brokenpotatoes/Servo/encoder/encoder.kicad_pcb

## KiCad design encoder/encoder.kicad_pcb (2026-03-05)

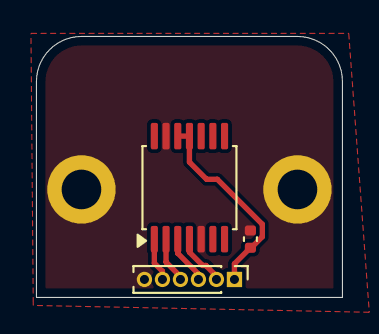
[picture p1: board encoder.kicad_pcb from above]

Board: 2 copper layers, 17.0 x 14.5 mm, 5 parts (0 on the bottom side), 6 nets.

Parts:
C1: 100nF; C_0402_1005Metric
H1, H2: MountingHole_Pad_MP; MountingHole_2.2mm_M2_DIN965_Pad
J1: Conn_01x06_Pin; PinHeader_1x06_P1.00mm_Vertical
U1: AS5047P; TSSOP-14_4.4x5mm_P0.65mm

Connections:
/ENC_CS: J1.5, U1.1 (~CS)
/MISO: J1.3, U1.3 (MISO)
/MOSI: J1.2, U1.4 (MOSI)
/SCK: J1.4, U1.2 (CLK)
GND: C1.2, H1.1, H2.1, J1.6, U1.5 (TST), U1.13 (GND)
VDD: C1.1, J1.1, U1.11 (VDD), U1.12 (VDD3V3)
