brokenpotatoes/Servo/terminator/terminator.kicad_pcb

## KiCad design terminator/terminator.kicad_pcb (2026-03-01)

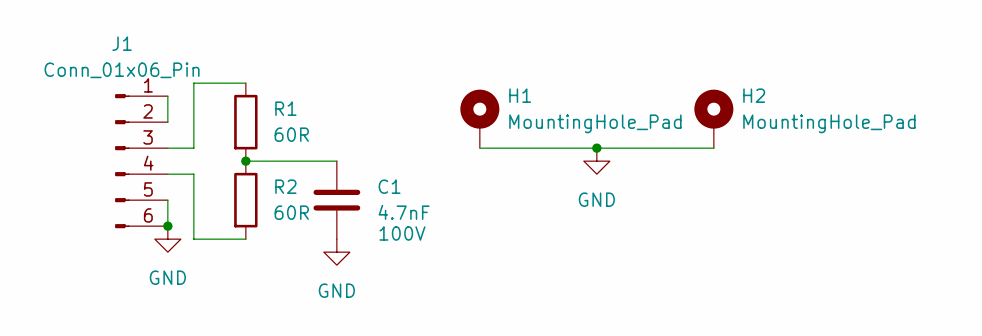
[picture p2: schematic terminator.kicad_sch]

Parts:
C1: 4.7nF; C_1206_3216Metric; Voltage Rating 100V; LCSC Part C393168
H1, H2: MountingHole_Pad; MountingHole_2.2mm_M2_Pad
J1: Conn_01x06_Pin; JST_XH_S6B-XH-A_1x06_P2.50mm_Horizontal; LCSC Part C157919
R1, R2: 60R; C_1206_3216Metric; LCSC Part C2086866

Connections:
GND: C1.2, H1.1, H2.1, J1.5, J1.6
unnamed: C1.1, R1.2, R2.1
unnamed: J1.1, J1.2
unnamed: J1.3, R1.1
unnamed: J1.4, R2.2

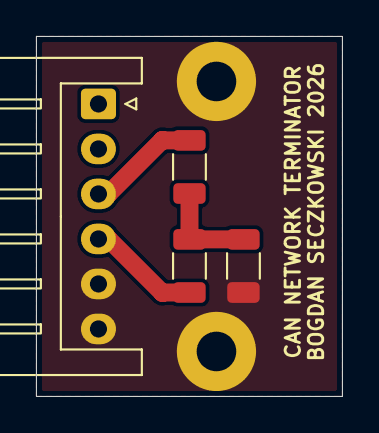
[picture p3: board terminator.kicad_pcb from above]

Board: 2 copper layers, 17.0 x 20.0 mm, 6 parts (0 on the bottom side), 5 nets.
