brokenpotatoes/Servo/servo/servo.kicad_pcb

## KiCad design servo/servo.kicad_pcb (2026-03-01)

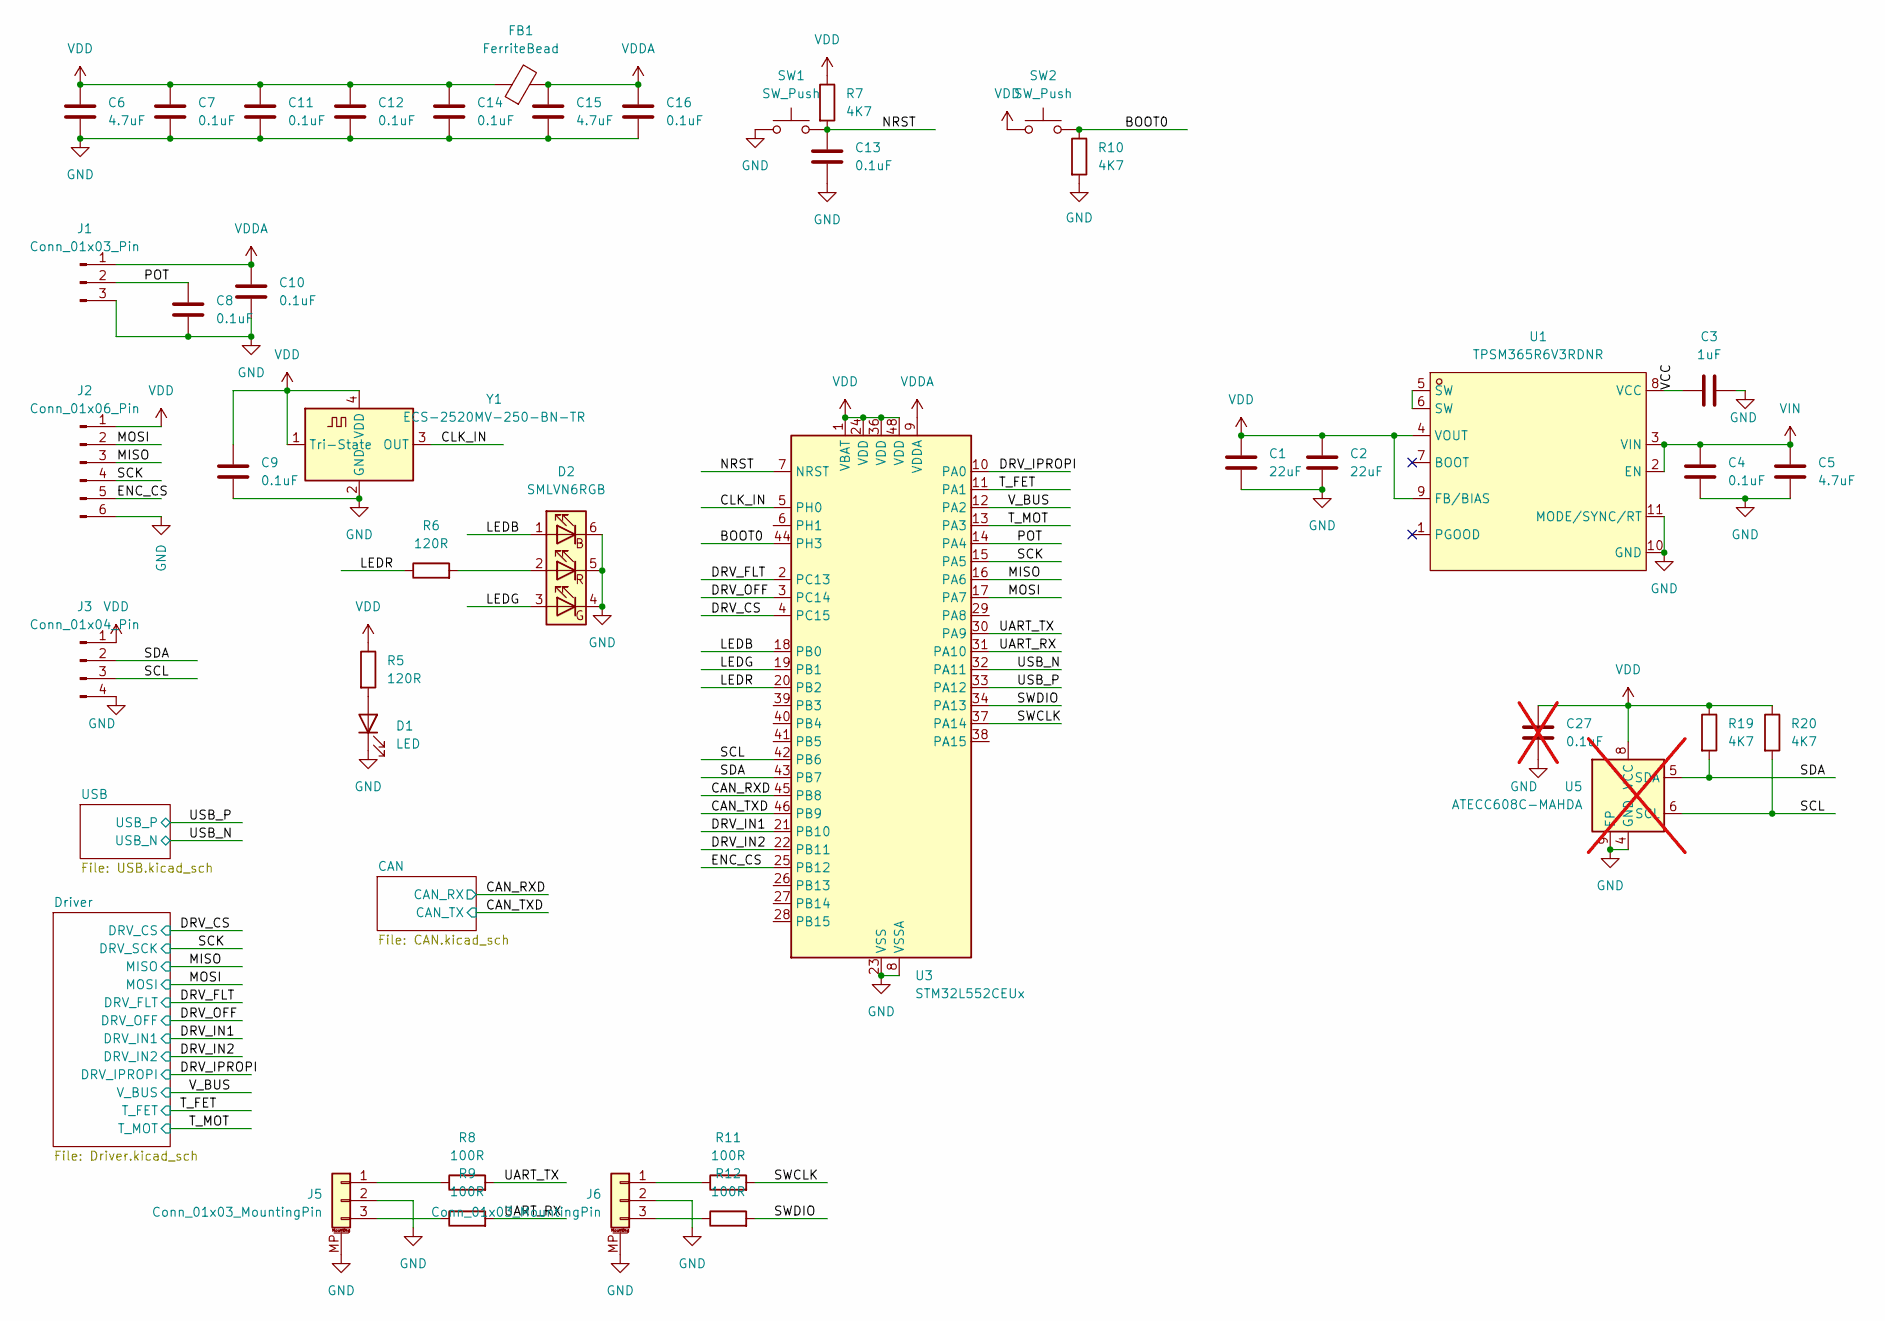
[picture p4: schematic servo.kicad_sch]

Parts:
C1, C2: 22uF; C_0402_1005Metric; Voltage Rating 10V; LCSC Part C3845593
C3: 1uF; C_0402_1005Metric; Voltage Rating 16V; LCSC Part C77006
C4: 0.1uF; C_0603_1608Metric; Voltage Rating 100V; LCSC Part C77058
C5: 4.7uF; C_1206_3216Metric; Voltage Rating 100V; LCSC Part C237304
C6, C15: 4.7uF; C_0402_1005Metric; Voltage Rating 16V; LCSC Part C318563
C7, C8, C9, C10, C11, C12, C13, C14, C16: 0.1uF; C_0402_1005Metric; Voltage Rating 16V; LCSC Part C71629
C27: 0.1uF; C_0402_1005Metric; Voltage Rating 16V; LCSC Part C71629; not fitted
D1: LED; LED_0402_1005Metric; LCSC Part C264407
D2: SMLVN6RGB; LED_ROHM_SMLVN6; LCSC Part C2909770
FB1: FerriteBead; L_0402_1005Metric; LCSC Part C88970
J1: Conn_01x03_Pin; PinHeader_1x03_P1.00mm_Vertical
J2: Conn_01x06_Pin; PinHeader_1x06_P1.00mm_Vertical
J3: Conn_01x04_Pin; PinHeader_1x04_P1.00mm_Vertical
J5, J6: Conn_01x03_MountingPin; JST_GH_SM03B-GHS-TB_1x03-1MP_P1.25mm_Horizontal; LCSC Part C514175
R5, R6: 120R; R_0402_1005Metric; LCSC Part C445577
R7, R10, R19, R20: 4K7; R_0402_1005Metric; LCSC Part C400631
R8, R9, R11, R12: 100R; R_0402_1005Metric; LCSC Part C844502
SW1, SW2: SW_Push; SW_SPST_PTS810; LCSC Part C221895
U1: TPSM365R6V3RDNR; QFN-11_L4.5-W3.5-P0.50-TL_TPSM365R6FRDNR; LCSC Part C18208843
U3: STM32L552CEUx; QFN-48-1EP_7x7mm_P0.5mm_EP5.6x5.6mm; LCSC Part C1236634
U5: ATECC608C-MAHDA; DFN-8-1EP_3x2mm_P0.5mm_EP1.3x1.5mm; LCSC Part C23291019; not fitted
Y1: ECS-2520MV-250-BN-TR; Oscillator_SMD_ECS_2520MV-xxx-xx-4Pin_2.5x2.0mm; LCSC Part C405463

Connections:
/BOOT0: R10.1, SW2.2, U3.44 (PH3)
/CAN_RXD: U3.45 (PB8); also elsewhere on the board
/CAN_TXD: U3.46 (PB9); also elsewhere on the board
/CLK_IN: U3.5 (PH0), Y1.3 (OUT)
/DRV_CS: U3.4 (PC15); also elsewhere on the board
/DRV_FLT: U3.2 (PC13); also elsewhere on the board
/DRV_IN1: U3.21 (PB10); also elsewhere on the board
/DRV_IN2: U3.22 (PB11); also elsewhere on the board
/DRV_IPROPI: U3.10 (PA0); also elsewhere on the board
/DRV_OFF: U3.3 (PC14); also elsewhere on the board
/ENC_CS: J2.5, U3.25 (PB12)
/LEDB: D2.1 (BA), U3.18 (PB0)
/LEDG: D2.3 (GA), U3.19 (PB1)
/LEDR: R6.1, U3.20 (PB2)
/MISO: J2.3, U3.16 (PA6); also elsewhere on the board
/MOSI: J2.2, U3.17 (PA7); also elsewhere on the board
/NRST: C13.1, R7.2, SW1.2, U3.7 (NRST)
/POT: C8.1, J1.2, U3.14 (PA4)
/SCK: J2.4, U3.15 (PA5); also elsewhere on the board
/SCL: J3.3, R20.2, U3.42 (PB6), U5.6 (SCL)
/SDA: J3.2, R19.2, U3.43 (PB7), U5.5 (SDA)
/SWCLK: R11.2, U3.37 (PA14)
/SWDIO: R12.2, U3.34 (PA13)
/T_FET: U3.11 (PA1); also elsewhere on the board
/T_MOT: U3.13 (PA3); also elsewhere on the board
/UART_RX: R9.2, U3.31 (PA10)
/UART_TX: R8.2, U3.30 (PA9)
/USB_N: U3.32 (PA11); also elsewhere on the board
/USB_P: U3.33 (PA12); also elsewhere on the board
/VCC: C3.1, U1.8 (VCC)
/V_BUS: U3.12 (PA2); also elsewhere on the board
GND: C1.2, C2.2, C3.2, C4.2, C5.2, C6.2, C7.2, C8.2, C9.2, C10.2, C11.2, C12.2, C13.2, C14.2, C15.2, C16.2, C27.2, D1.1 (K), D2.4 (GK), D2.5 (RK), D2.6 (BK), J1.3, J2.6, J3.4, J5.2, J5.MP (MountPin), J6.2, J6.MP (MountPin), R10.2, SW1.1, U1.10 (GND), U1.11 (MODE/SYNC/RT), U3.8 (VSSA), U3.23 (VSS), U3.35 (VSS), U3.47 (VSS), U3.49 (VSS), U5.4 (GND), U5.9 (EP), Y1.2 (GND); also elsewhere on the board
unnamed: D1.2 (A), R5.2
unnamed: D2.2 (RA), R6.2
unnamed: J5.1, R8.1
unnamed: J5.3, R9.1
unnamed: J6.1, R11.1
unnamed: J6.3, R12.1
unnamed: U1.5 (SW), U1.6 (SW)
VDD: C1.1, C2.1, C6.1, C7.1, C9.1, C11.1, C12.1, C14.1, C27.1, FB1.1, J2.1, J3.1, R5.1, R7.1, R19.1, R20.1, SW2.1, U1.4 (VOUT), U1.9 (FB/BIAS), U3.1 (VBAT), U3.24 (VDD), U3.36 (VDD), U3.48 (VDD), U5.8 (VCC), Y1.1 (Tri-State), Y1.4 (VDD); also elsewhere on the board
VDDA: C10.1, C15.1, C16.1, FB1.2, J1.1, U3.9 (VDDA); also elsewhere on the board
VIN: C4.1, C5.1, U1.2 (EN), U1.3 (VIN); also elsewhere on the board

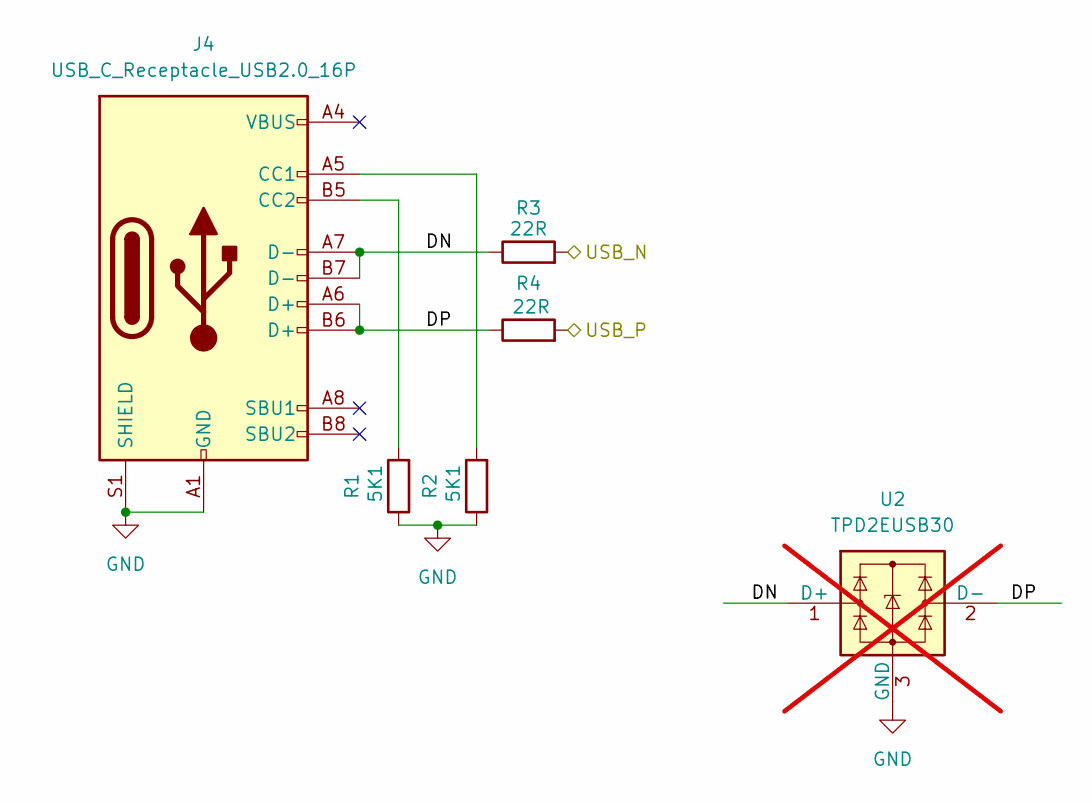
[picture p5: schematic USB.kicad_sch]

Parts:
J4: USB_C_Receptacle_USB2.0_16P; USB_C_Receptacle_GCT_USB4105-xx-A_16P_TopMnt_Horizontal; LCSC Part C3020560
R1, R2: 5K1; R_0402_1005Metric; LCSC Part C278598
R3, R4: 22R; R_0402_1005Metric; LCSC Part C482106
U2: TPD2EUSB30; Texas_DRT-3; LCSC Part C94934; not fitted

Connections:
/USB/DN: J4.A7 (D-), J4.B7 (D-), R3.1, U2.1 (D+)
/USB/DP: J4.A6 (D+), J4.B6 (D+), R4.1, U2.2 (D-)
/USB_N: R3.2; also elsewhere on the board
/USB_P: R4.2; also elsewhere on the board
GND: J4.A1 (GND), J4.A12 (GND), J4.B1 (GND), J4.B12 (GND), J4.S1 (SHIELD), R1.1, R2.1, U2.3 (GND); also elsewhere on the board
unnamed: J4.A5 (CC1), R2.2
unnamed: J4.B5 (CC2), R1.2

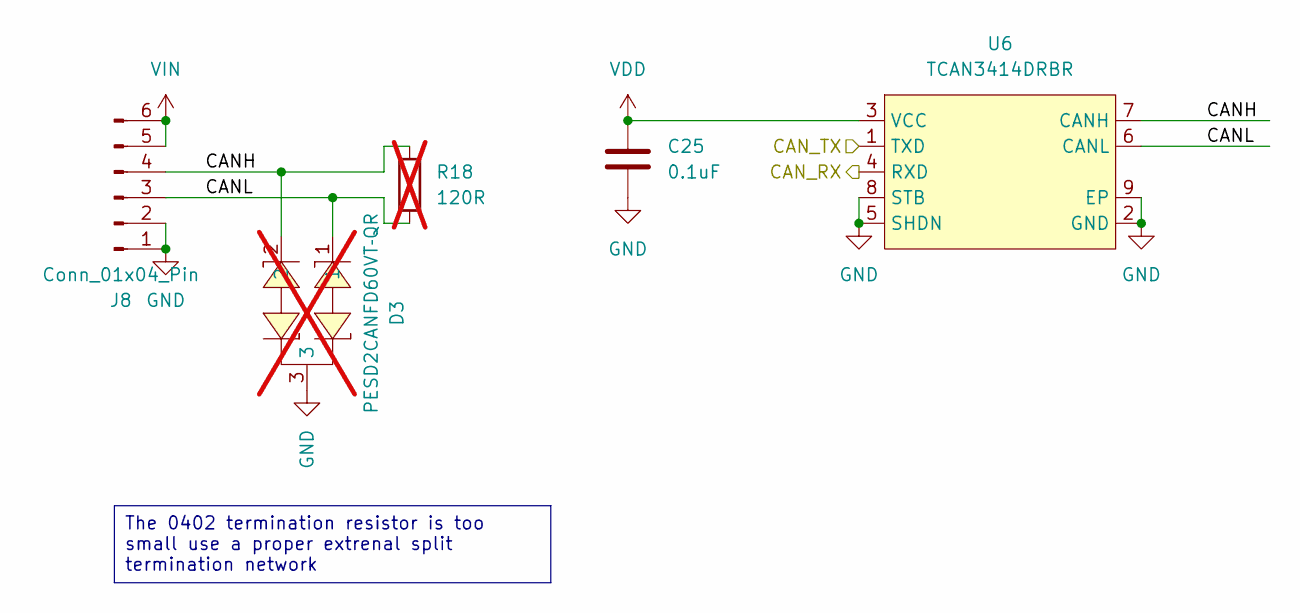
[picture p6: schematic CAN.kicad_sch]

Parts:
C25: 0.1uF; C_0402_1005Metric; Voltage Rating 16V; LCSC Part C71629
D3: PESD2CANFD60VT‑QR; SOT-23-3_L2.9-W1.3-P1.90-LS2.4-BL-1; LCSC Part C3711787; not fitted
J8: Conn_01x04_Pin; JST_XH_S6B-XH-A_1x06_P2.50mm_Horizontal; LCSC Part C157919
R18: 120R; R_0402_1005Metric; LCSC Part C445577; not fitted
U6: TCAN3414DRBR; WSON-8_L3.0-W3.0-P0.65-TL-EP; LCSC Part C31542495

Connections:
/CAN/CANH: D3.2, J8.4, R18.2, U6.7 (CANH)
/CAN/CANL: D3.1, J8.3, R18.1, U6.6 (CANL)
/CAN_RXD: U6.4 (RXD); also elsewhere on the board
/CAN_TXD: U6.1 (TXD); also elsewhere on the board
GND: C25.2, D3.3, J8.1, J8.2, U6.2 (GND), U6.5 (SHDN), U6.8 (STB), U6.9 (EP); also elsewhere on the board
VDD: C25.1, U6.3 (VCC); also elsewhere on the board
VIN: J8.5, J8.6; also elsewhere on the board

Notes on the sheet:
The 0402 termination resistor is too small use a proper extrenal split termination network

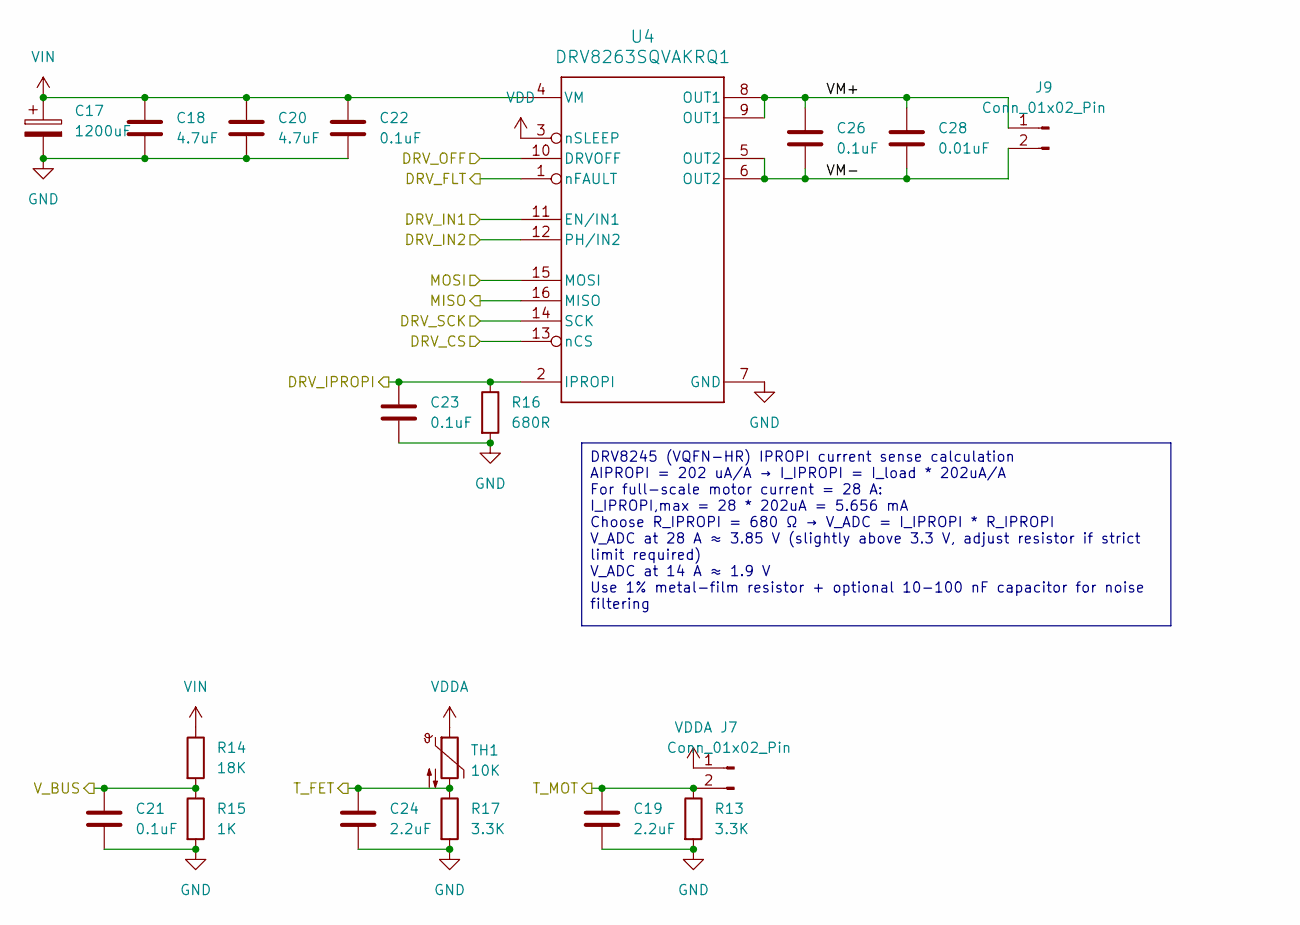
[picture p7: schematic Driver.kicad_sch]

Parts:
C17: 1200uF; Rubycon 63ZLJ1200M18X20; Voltage Rating 63V; LCSC Part C700866
C18, C20: 4.7uF; C_1206_3216Metric; Voltage Rating 100V; LCSC Part C237304
C19, C24: 2.2uF; C_0402_1005Metric; Voltage Rating 16V; LCSC Part C170151
C21, C23: 0.1uF; C_0402_1005Metric; Voltage Rating 16V; LCSC Part C71629
C22, C26: 0.1uF; C_0603_1608Metric; Voltage Rating 100V; LCSC Part C77058
C28: 0.01uF; C_0603_1608Metric; Voltage Rating 100V; LCSC Part C161232
J7: Conn_01x02_Pin; PinHeader_1x02_P1.00mm_Vertical; LCSC Part C3000141
J9: Conn_01x02_Pin; Servo
R13, R17: 3.3K; R_0402_1005Metric; LCSC Part C445607
R14: 18K; R_0402_1005Metric; LCSC Part C482065
R15: 1K; R_0402_1005Metric; LCSC Part C242161
R16: 680R; R_0402_1005Metric; LCSC Part C242161
TH1: 10K; R_0402_1005Metric; LCSC Part C209959
U4: DRV8263SQVAKRQ1; RXZ0016A-MFG; LCSC Part C51893863

Connections:
/DRV_CS: U4.13 (nCS); also elsewhere on the board
/DRV_FLT: U4.1 (nFAULT); also elsewhere on the board
/DRV_IN1: U4.11 (EN/IN1); also elsewhere on the board
/DRV_IN2: U4.12 (PH/IN2); also elsewhere on the board
/DRV_IPROPI: C23.1, R16.1, U4.2 (IPROPI); also elsewhere on the board
/DRV_OFF: U4.10 (DRVOFF); also elsewhere on the board
/Driver/VM+: C26.1, C28.1, J9.1, U4.8 (OUT1), U4.9 (OUT1)
/Driver/VM-: C26.2, C28.2, J9.2, U4.5 (OUT2), U4.6 (OUT2)
/MISO: U4.16 (MISO); also elsewhere on the board
/MOSI: U4.15 (MOSI); also elsewhere on the board
/SCK: U4.14 (SCK); also elsewhere on the board
/T_FET: C24.1, R17.1, TH1.2; also elsewhere on the board
/T_MOT: C19.1, J7.2, R13.1; also elsewhere on the board
/V_BUS: C21.1, R14.2, R15.1; also elsewhere on the board
GND: C17.2, C18.2, C19.2, C20.2, C21.2, C22.2, C23.2, C24.2, R13.2, R15.2, R16.2, R17.2, U4.7 (GND); also elsewhere on the board
VDD: U4.3 (nSLEEP); also elsewhere on the board
VDDA: J7.1, TH1.1; also elsewhere on the board
VIN: C17.1, C18.1, C20.1, C22.1, R14.1, U4.4 (VM); also elsewhere on the board

Notes on the sheet:
DRV8245 (VQFN-HR) IPROPI current sense calculation AIPROPI = 202 uA/A → I_IPROPI = I_load * 202uA/A For full-scale motor current = 28 A: I_IPROPI,max = 28 * 202uA = 5.656 mA Choose R_IPROPI = 680 Ω → V_ADC = I_IPROPI * R_IPROPI V_ADC at 28 A ≈ 3.85 V (slightly above 3.3 V, adjust resistor if strict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

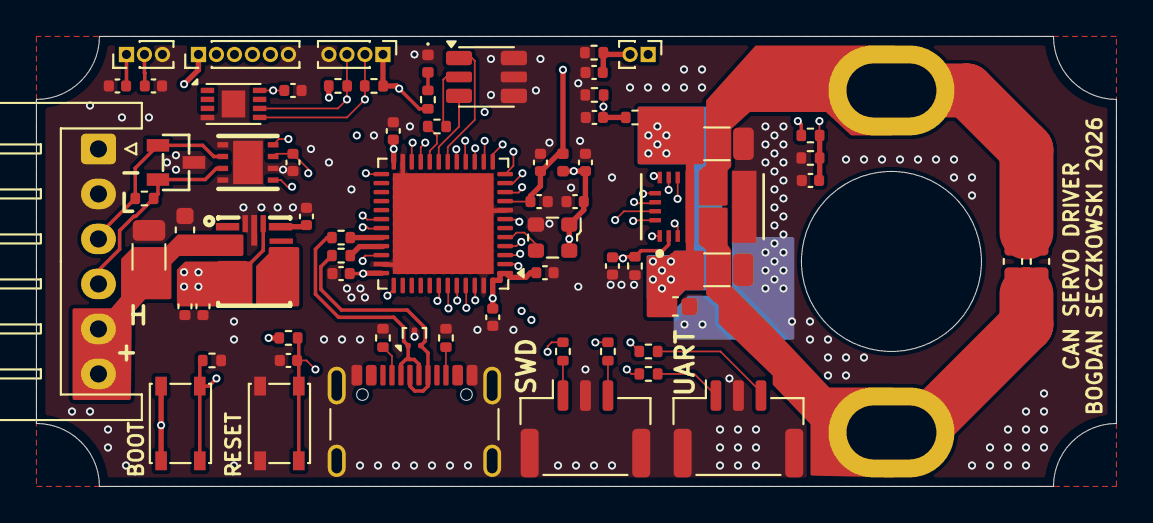
[picture p8: board servo.kicad_pcb from above]

Board: 6 copper layers, 60.0 x 25.0 mm, 71 parts (1 on the bottom side), 50 nets.
