brokenpotatoes/Servo/(commit log)

2026-03-01 Initial Upload
    [CAN.kicad_sch, Driver.kicad_sch, USB.kicad_sch, encoder.kicad_pcb, encoder.kicad_sch, servo.kicad_pcb, servo.kicad_sch, terminator.kicad_pcb]
2026-03-01 Add BOMs
    [encoder.csv, servo.csv, terminator.csv]
2026-03-05 Made the encoder PCB
    [Driver.kicad_sch, encoder.kicad_pcb, encoder.kicad_sch, servo.csv]
